speicherl/ChrisBox/CODE/Platformio_Project/README.md

# Code

Welcome to the PlatformIO folder of ChrisBox!
The Arduino Code for ChrisBox is now imported to PlatformIO.

## Content of the PlatformIO folder
    - The Arduino File of  `../ChrisBox_Code` is imported for PlatformIO via symbolic link.
## Flashing the code on the PCB
    - If you dont know how to flash, use the Arduino IDE and the Code in  `../ChrisBox_Code`, its more beginner-friendly
    - More Help in [BUILDING INSTRUCTIONS](/BUILDING_INSTRUCTIONS.md).
