speicherl/ChrisBox/(commit log)

2026-02-04 Added Conversion Voltage jumps to Charge
2026-09-07 initialised Platformio Project with content from Arduino IDE and added Installer for UART Converter Driver for windows
2026-10-06 Avoid duplicated code, use symlink for PlatformIO code.
    [ChrisBox_Code.ino]
2026-10-06 Fix parameter types, clear trailing whitespace.
    [ChrisBox_Code.ino]
